Dominik-Workshop/KD-23MTS/documentation_PL.pdf

Projekt

Sterowniki robotów

# Dokumentacja

# Oscyloskop

# KD 23MTS

Skład grupy:
Dominik Pluta, 263460
Kamil Winnicki, 263434

Termin: srTN17

Prowadzący:
dr inż. Wojciech Domski

5 czerwca 2024

## Spis treści

1 Opis projektu | 2
2 Konfiguracja mikrokontrolera | 4
3 Urządzenia zewnętrzne | 8
4 Projekt elektroniki | 10
5 Opis działania programu | 11
6 Harmonogram pracy | 18
7 Podsumowanie | 19
8 Link do repozytorium projektu | 19
Bibilografia | 19

## 1 Opis projektu

Oscyloskop [2] [3] zbudowany w oparciu o mikrokontroler STM32L474RG oraz dotykowy, 4"wyświetlacz LCD. Stworzone urządzenie będzie posiadało następujące funkcjonalności:

- dwa kanały,
- skalowanie osi X oraz Y,
- przesuwanie wykresu w osi X oraz Y,
- dwa kursory w osi X oraz Y,
- pomiar RMS,
- pomiar peak-to-peak,
- pomiar częstotliwości,
- trigger,
- szybką transformate fouriera,

Do obsługi oscyloskopu przez użytkownika wykorzystany będzie enkoder oraz dotyk w ekranie.

Do testów oscyloskopu wykorzystany będzie sygnał PWM wygenerowany na jednym z pinów mikrokontrolera.

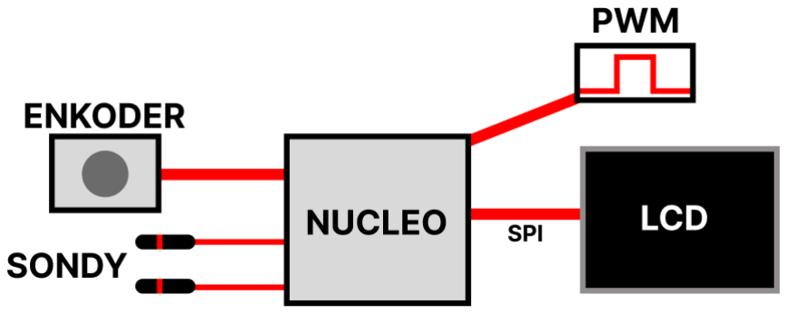
[picture p3: figure]

Rysunek 1: Architektura systemu

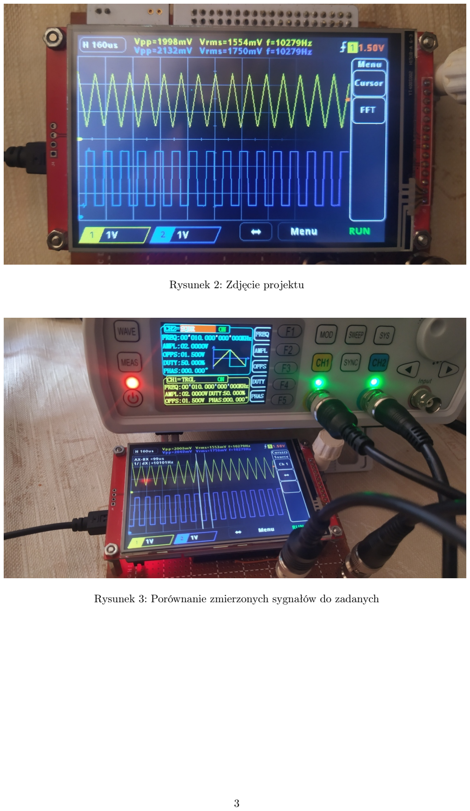
[picture p4: page 4]

Rysunek 2: Zdjęcie projektu

Rysunek 3: Porównanie zmierzonych sygnałów do zadanych

## 2 Konfiguracja mikrokontrolera

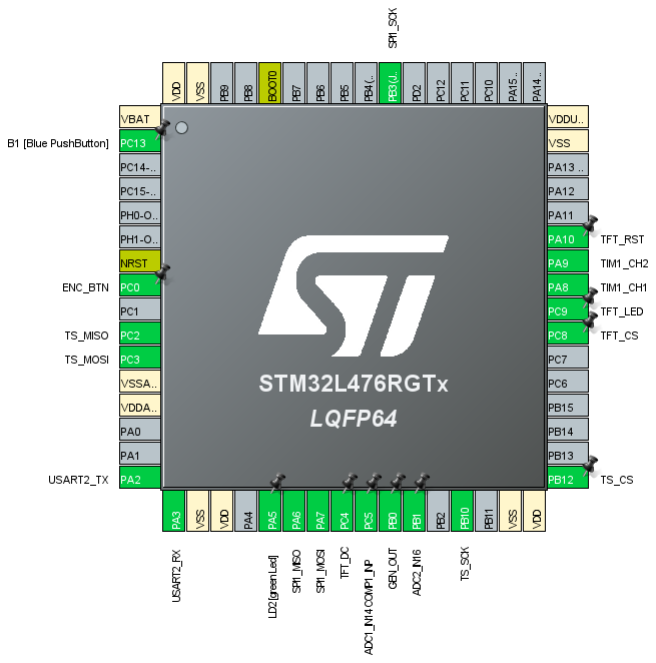
[picture p5: figure]

Rysunek 4: Konfiguracja wyjść mikrokontrolera w programie STM32CubeMX

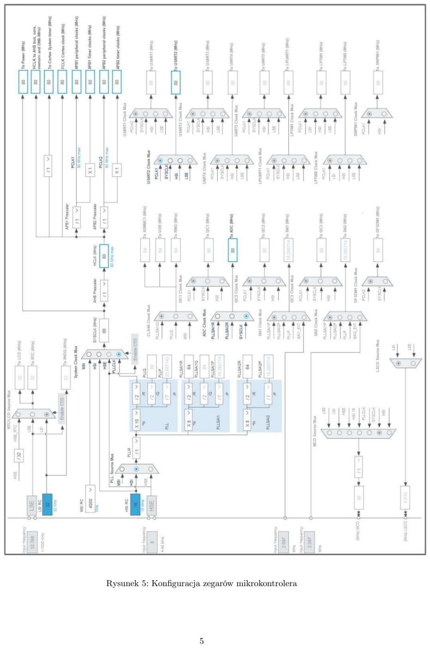
[picture p6: page 6]

Rysunek 5: Konfiguracja zegarów mikrokontrolera

### 2.1 Konfiguracja pinów

Numer pinu | PIN | Tryb pracy | Funkcja/etykieta
2 8 10 11 16 17 21 22 23 24 25 26 27 29 33 39 40 41 42 43 55 | PC13 PC0 PC2 PC3 PA2 PA3 PA5 PA6 PA7 PC4 PC5 PB0 PB1 PB10 PB12 PC8 PC9 PA8 PA9 PA10 PB3 | GPIO_EXTI13 GPIO_Input SPI_MISO SPI_MOSI USART2_TX USART2_RX GPIO_Output SPI_MISO SPI_MOSI GPIO_Output ADC1_IN2, COMP1_NP GPIO_Output ADC2_IN16 SPI2_SCK GPIO_Output GPIO_Output TIM3_CH4 TIM1_CH1 TIM1_CH2 GPIO_Output SPI1_SCK | B1 [Blue PushButton] ENC_BTN TS_MISO TS_MOSI USART2_TX USART2_RX LD2 [green Led] SPI1_MISO SPI1_MOSI TFT_DC CH1 & trigger GEN_OUT CH2 TS_SCK TS_CS TFT_CS TFT_LED TIM1_CH1 TIM1_CH2 TFT_RST SPI2_SCK

Tabela 1: Konfiguracja pinów mikrokontrolera

### 2.2 SPI1

Konfiguracja peryferium interfejsu SPI, wykorzystywanego do komunikacji z LCD. Wszystkie piny tego peryferium mają ustawione ’Maximum output’ speed na ’Very High’.

Parametr | Wartość
Mode | Full-Duplex Master
Frame Format | Motorola
Data Size | 8 bit
First bit | MSB first
Prescaler (for Baud Rate) | 2 (40 MBits/s)
Clock polarity | Low
Clock phase | 1 Edge

Tabela 2: Konfiguracja peryferium SPI

### 2.3 SPI2

Konfiguracja peryferium interfejsu SPI, wykorzystywanego do komunikacji z panelem dotykowym na LCD. Wszystkie piny tego peryferium mają ustawione ’Maximum output’ speed na ’Very High’.

Parametr | Wartość
Mode | Full-Duplex Master
Frame Format | Motorola
Data Size | 8 bit
First bit | MSB first
Prescaler (for Baud Rate) | 16 (5 MBits/s)
Clock polarity | Low
Clock phase | 1 Edge

Tabela 3: Konfiguracja peryferium SPI

### 2.4 ADC

Wykorzystujemy wbudowane przetworniki ADC w mikrokontrolerze. ADC1 odpowiada za pomiary z kanału 1 oscyloskopu, natomiast ADC2 za pomiary z kanału 2 oscyloskopu. Oba przetworniki zostały skonfigurowane w poniższy sposób.

Parametr | Wartość
Resolution | 12-bit
Continous conversion mode | Enabled
DMA Continuous Requests | Enabled
Sampling time | 6.5 Cycles

Tabela 4: Konfiguracja ADC

### 2.5 COMP1

Konfiguracja komparatora wykorzystywaego do implementacji triggera.

Parametr | Wartość
Input [-] | DAC OUT1
Speed/Power Mode | High Speed
Trigger Mode | Rising Edge Interrupt
Hysteresis Level | Low

Tabela 5: Konfiguracja komparatora

### 2.6 DAC1

Konfiguracja DAC używanego do implementacji triggera.

Parametr | Wartość
OUT1 mode | Connected to on chip-peripherals only
Output Buffer | Disable
Trigger | None

Tabela 6: Konfiguracja DAC

### 2.7 DMA

Używamy DMA do wysyłania danych do wyświetlacza, oraz zbierania próbek z ADC.

DMA request | Stream | Direction | Priority
SPI1_TX | DMA1_Channel3 | Memory To Peripheral | Low
ADC1 | DMA1_Channel1 | Peripheral To Memory | Low
ADC2 | DMA1_Channel2 | Peripheral To Memory | Low

Tabela 7: Konfiguracja DMA

### 2.8 TIM1

Timer 1 został wykorzystany do obsługi enkodera inkrementalnego.

Parametr | Wartość
Prescaler | 0
Counter Mode | Up
Counter Period | 65535
Internal Clock Division | No Division
Repetition Counter | 0
auto-reload preload | Disable
Encoder Mode | Encoder Mode TI1
Polarity | Rising Edge

Tabela 8: Konfiguracja TIM1

### 2.9 TIM4

Timer 4 został wykorzystany do wyzwalania pomiarów ADC gdy komparator ich nie wyzwala. Został skonfigurowany tak, żeby wyzwalał przerwanie co sekundę:

U pdate_event =

T IM_CLK
(P SC + 1)(ARR + 1)Hz | (1)

TIM_CLK = 80MHz, PSC = 7999, ARR = 9999

U pdate_event =

80MHz
(7999 + 1) ∗ (9999 + 1) = 1Hz | (2)
Parametr | Wartość
Prescaler | 7999
Counter Mode | Up
Counter Period | 9999
Internal Clock Division | No Division
auto-reload preload | Disable
Trigger Event Selection TRGO | Update Event

Tabela 9: Konfiguracja TIM4

### 2.10 USART2

Komunikacja przez USART jest wykorzystywana przy kalibracji dotyku wyświetlacza do wysłania m.in. nowych wartości kalibracyjnych.

Parametr | Wartość
Baud Rate | 115200 Bits/s
Word Length | 8 Bits (including parity)
Parity | None
Stop Bits | 1

Tabela 10: Konfiguracja USART

## 3 Urządzenia zewnętrzne

### 3.1 Wyświetlacz dotykowy LCD 480x320px

Wyświetlacz oparty jest o sterownik ILI9488 [1]. Dotyk w wyświetlaczu obsługiwany jest przez sterownik XPT2046.

### 3.2 Enkoder obrotowy KY-040

Enkoder będzie wykorzystywany do takich funkcji jak:

- skalowanie wykresu,
- przesuwanie wykresu,
- ustawianie triggera,
- ustawianie kursorów,

W celu obsługi tego peryferium TIMER 1 został skonfigurowany w trybie: "Combined Channels -Encoder Mode" [4]
Wyjścia DT oraz CLK zostały podpięte do wyjść timera 1 TIM1-CH1 oraz TIM1-CH2 co odpowiada pinom PA8 oraz PA9.
Odczyt impulsów z enkodera odbywa się poprzez odczyt wartości rejestru
htim1.Instance− > CNT | (3)

## 4 Projekt elektroniki

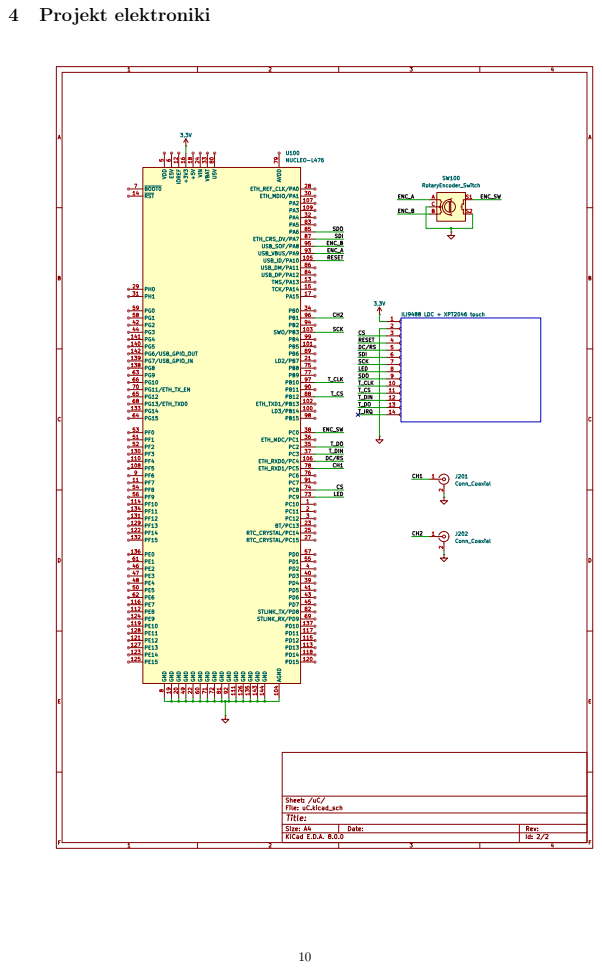
[picture p7: page 11]

## 5 Opis działania programu

### 5.1 Obsługa interfejsu

Obsługa większości funkcji oscyloskopu oparta jest o dotykowy wyświetlacz.
Dostępna funkcjonalność wyświetlacza:
- Po kliknięciu w wartość podzialki czasu na kratke, za pomocą enkodera można zmienić jej wartość,
- Po pierwszym kliknięciu w lewym dolnym rogu w odpowiedni kanał pojawia się menu gdzie po wyborze odpowiedniej opcji (skalowanie albo przesuwanie) można za pomocą enkodera wykonywać odpowiednie operacje.
- Kolejne kliknięcie w dany kanał powoduje wyświetlanie lub zaprzestanie wyświetlania wykresu.
- W sytuacji kliknięcia przycisku Menu, włącza się menu z dostępnymi opcjami: kursory oraz FFT.

### 5.2 Pomiary sygnałów z użyciem ADC

Jeden piksel na wyświetlaczu odpowiada jednej próbce z ADC, więc częstotliwość próbkowania została dobrana tak, aby przy 10 µs na działkę było zebranych 42 próbki (tyle pikseli ma jedna podziałka), więc powinna ona wynosić 4,2 MHz.
Częstotliwość próbkowania można wyliczyć ze wzoru (zakładając, że Clock Prescaler = ADC_CLOCK_ASYNC_DIV1):

fsampling =

ADC_clock
Sampling time + 12.5

Dobrałem wartości: ADC_clock = 80 MHz, Sampling time = 6.5

fsampling =

80 MHz
6.5 + 12.5

= 4.210526 MHz

Uzyskana częstotliwość odbiega od założonej, lecz rozbieżność ta jest pomijalnie mała. Jednakże lepszym rozwiązeniem prawdopodonie było by uniezależnienie częstotliwości próbkowania od ilości pikseli na działkę i skalowanie wyresu przez zmianę sposobu rysowania go.
Częstotliwość próbkowania ADC jest zmieniana w zależności od ustawionej podstawy czasu, dzięki czemu uzyskiwane jest skalowanie wykresu w dziedzinie czasu. Do wyboru jest 9 wartości podstawy czasu: 10, 20, 40, 80, 160, 320, 640, 1280 i 2560 µs. Zostało to zrealizowane w następujący sposób.
1 | swi t c h ( o s c i l l o s c o p e . timeBase_us ) {
2 | c a s e 1 0:
3 | hadc1 . I n i t . Cl o c kP r e s c al e r = ADC_CLOCK_ASYNC_DIV1;
4 | break ;
5 | c a s e 2 0:
6 | hadc1 . I n i t . Cl o c kP r e s c al e r = ADC_CLOCK_ASYNC_DIV2;
7 | break ;
8 | . . .
9 | . . .
10 | . . .
11 | c a s e 2 5 6 0:
12 | hadc1 . I n i t . Cl o c kP r e s c al e r = ADC_CLOCK_ASYNC_DIV256;
13 | break ;
14
15 | // I n i t i a l i z e the ADC with the c o n fi g u r e d s e t t i n g s
16 | i f (HAL_ADC_Init(&hadc1 ) != HAL_OK) {
17 | // I n i t i a l i z a t i o n E r r o r
18 | Error_Handler ( ) ;
19 | }
20 | }
| Warto zwrócić uwagę, żę powyższy kod zmienia prescaler dla zarówno dla ADC1, jak i dla ADC2.

### 5.3 Implementacja triggera

Przetwornik DAC1 ustawia napięcie zadziałania triggera następującą funkcją:

1 | HAL_DAC_SetValue(&hdac1 , DAC_CHANNEL_1, DAC_ALIGN_12B_R, conv_voltage_to_DAC (
| o s c i l l o s c o p e . triggerLevel_mV / 1 0 0 0. 0 ) ) ;
| Napięcie to jest odbierane na odwracającym wejściu komparatora COMP1 i jest porównywane z napięciem
| na wejściu nieodwracającym, które jest podłączone na tym samym pinie, co wejście kanału 1 oscyloskopu.
| Na zboczu narastającym sygnału na kanale 1 oscyloskopu, gdy wartość dorównuje napięciu ustawionemu
| przez DAC, wyzwalane jest przerwanie startujące zbieranie próbek na obu kanałach.
1 | v oid HAL_COMP_TriggerCallback (COMP_HandleTypeDef ∗hcomp ) {
2 | c omp a r a t o rT ri g ge redFl a g = 1 ;
3 | i f ( conv_done & done_drawing ) {
4 | conv_done = 0 ;
5 | HAL_ADC_Start_DMA(&hadc1 , ( uint32_t ∗) o s c i l l o s c o p e . ch1 . waveform_raw_adc ,
| MEMORY_DEPTH) ;
6 | HAL_ADC_Start_DMA(&hadc2 , ( uint32_t ∗) o s c i l l o s c o p e . ch2 . waveform_raw_adc ,
| MEMORY_DEPTH) ;
7 | ready_to_draw = 1 ;
8 | done_drawing = 0 ;
9 | }
10 | }
| Aby zapewnić działanie pomiaru sygnału nie wyzwalającego triggera, został użyty timer generujący
| przerwanie co sekundę, który startuje ADC, jeśli flaga mówiąca o wyzwoleniu komparatora nie jest usta-
| wiona, oraz gdy oscyloskop nie jest w trybie zatrzymania pomiaru.
1 | v oid HAL_TIM_PeriodElapsedCallback ( TIM_HandleTypeDef ∗htim ) {
2 | i f ( htim == &htim4 ) {
3 | i f ( ! c omp a r a t o rT ri g ge redFl a g && ! o s c i l l o s c o p e . s t o p ) {
4 | HAL_ADC_Start_DMA(&hadc1 , ( uint32_t ∗) o s c i l l o s c o p e . ch1 . waveform_raw_adc ,
| MEMORY_DEPTH) ;
5 | HAL_ADC_Start_DMA(&hadc2 , ( uint32_t ∗) o s c i l l o s c o p e . ch2 . waveform_raw_adc ,
| MEMORY_DEPTH) ;
6 | done_drawing = 0 ;
7 | }
8 | }
9 | }

### 5.4 Rysowanie wykresu

Poniższy kod rysuje wykres sygnału na ekranie. Warto zwrócić uwagę na użycie zmiennej offsetBetweenChannels, która służy zniwelowaniu przesunięcia fazowego między dwoma kanałami, powstałemu przez nie idealnie jednoczesne startowanie ADC.

1 | v oid draw_waveform ( O s cill o s c o p e_ c h a n n el ∗ ch , uint64_t timeBase_us , i n t o f f s e t , i n t
| s t o p ) {
2 | c o n s t ui n t o f f s e tB e tw e e nC h a n n el s = 3 6 0;
3 | f o r ( i n t i = 0 ; i < CANVA_WIDTH; ++i ) {
4 | i f ( ch−>number == 1 )
5 | ch−>wave form_display [ i ] = convertAdcToVoltage ( ch−>waveform_raw_adc [ i+o f f s e t
| +( o f f s e tB e tw e e nC h a n n el s / timeBase_us ) ] ) ∗1 0 0 0;
6 | e l s e
7 | ch−>wave form_display [ i ] = convertAdcToVoltage ( ch−>waveform_raw_adc [ i+o f f s e t
| ] ) ∗1 0 0 0;
8 | }
9 | f o r ( i n t i = 0 ; i < 420−1; ++i ) {
10 | i n t x0 = i ;
11 | i n t x1 = i +1;
12 | i n t y0 = CANVA_MIDDLE_V − ch−>y_ o f f s e t − ( ch−>wave form_display [ i ] ∗ 4 2 ) /ch−>
| y_scale_mV ;
13 | i n t y1 = CANVA_MIDDLE_V − ch−>y_ o f f s e t − ( ch−>wave form_display [ i +1]∗42) /ch−>
| y_scale_mV ;
14 | \\ Ensure t h a t the waveform f i n t s on the canva
15 | i f ( y0 < 3 2 )
16 | y0 = 3 2;
17 | i f ( y0 > 2 8 4 )
18 | y0 = 2 8 4;
19 | i f ( y1 < 3 2 )
20 | y1 = 3 2;
21 | i f ( y1 > 2 8 4 )
22 | y1 = 2 8 4;
23 | drawLine ( x0 , y0 , x1 , y1 , ch−>c o l o r ) ;
24 | }
25 | }

### 5.5 Pomiar peak-to-peak

1 | uint32_t calculate_peak_to_peak ( uint32_t ∗waveform ) {
2 | uint32_t max=0, min ;
3 | min = 5 0 0 0 0;
4 | f o r ( i n t i = 0 ; i < CANVA_WIDTH; ++i ) {
5 | i f ( waveform [ i ]<min ) {
6 | min=waveform [ i ] ;
7 | }
8 | i f ( waveform [ i ]>max) {
9 | max=waveform [ i ] ;
10 | }
11 | }
12 | r e t u r n max−min ;
13 | }

### 5.6 Pomiar RMS

1 | uint32_t calculate_RMS ( uint32_t ∗waveform ) {
2 | uint64_t sum_of_squares = 0 ;
3 | f o r ( i n t i = 0 ; i < CANVA_WIDTH; ++i ) {
4 | sum_of_squares += waveform [ i ] ∗ waveform [ i ] ;
5 | }
6 | f l o a t mean_of_squares = ( f l o a t ) sum_of_squares / CANVA_WIDTH;
7 | f l o a t rms = s q r t f ( mean_of_squares ) ;
8 | r e t u r n rms ;
9 | }

### 5.7 Obsługa wyświetlacza

Aby zapewnić akceptowalne działanie wyświetlacza zmodyfikowałem bibliotekę https://github.com/offpic/ILI9488-DMA-SPI-STM32-4-3.95-INCH-STM32F103-TOUCH, (https://github.com/offpic/ILI9488-DMA-SPI-STM32-4-3.95-INCH-STM32F103-TOUCH) aby używała bufora do rysowania na wyświetlaczu. Dzięki temu, obraz nie miga przy rysowaniu. Wadą takiego rozwiązania jest bardzo duże zużycie pamięci.

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

### 5.8 Kursory

W programie zawarte sa dwa rodzaje kursorów do wykonywania pomiarów:

- kursory poziome w osi Y - do pomiaru amplitudy,
- kursory pionowe w osi X - do pomiaru czasu,

Interfejs kursorów jako otwierane menu składa się z wyboru kanału, wyboru między kursorem w osi X i Y, oraz wyświetlenie wyniku pomiaru. Za pomocą kursorów pionowych dodatkowo można zmierzyć częstotliwość.
Kursory te działają w następujący sposób (Na przykładzie kursorów pionowych):
- Ustawienie danego kursora odbywa się na podstawie odczytu z enkodera gdzie ilość impulsów przekłada się bezpośrednio na pozycje, czyli gdy ilość impulsów równa się 200, kursor rysowany jest na pozycji 200-tego piksela w danej osi. Wartość ta dodawana jest do zmiennej globalnej, dla każdego z pojedynczych kursorów a następnie rejestr odpowiedzialny za ilość impulsów na enkoderze jest zerowany. Zmiana kursora odbywa się poprzez naciśniecie przycisku na enkoderze. Zaimplementowane jest również ograniczenie przesuwania kursorów aby nie wychodzily one poza kratki na wyswietlaczu.
- Obliczenie czasu lub amplitudy odbywa się za pomocą wzoru:
1 | time_1 = ( time_cursor_1 ∗ time_per_grid ) /PX_PER_GRID_X;
2 | time_2 = ( time_cursor_2 ∗ time_per_grid ) /PX_PER_GRID_X;
3
4 | time | = time_2 − time_1 ;

Gdzie:

– time 1 oraz time 2, zmienne w których przechowywany jest czas: "od zera do kursora"

– time-cursor-1 oraz time-cursor-2, są to zmienne przechowujące pozycje na którym pikselu znajduje się aktualnie kursor,

– time-per-grid, podziałka czas na kratke,

– PX-PER-GRID, ilośc pikseli na kratke na siatce wyswietlacza, wyznaczany ze wzoru: rozmiar wyświetlacza(w pikselach) / ilość kratek,

Przykład: kursor 1 = 105, kursor 2 = 210, czas na kratke = 100ms, piksele na kratke = 42,

time1 = ((105 ∗ 100)/42) = 250 | (4)
time2 = ((210 ∗ 100)/42) = 500 | (5)
time = 500 − 250 = 250ms | (6)

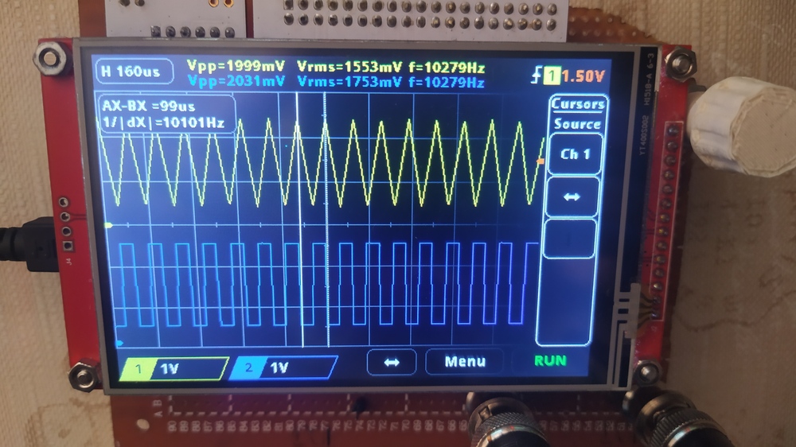
[picture p8: figure]

Rysunek 6: Kursory w osi X

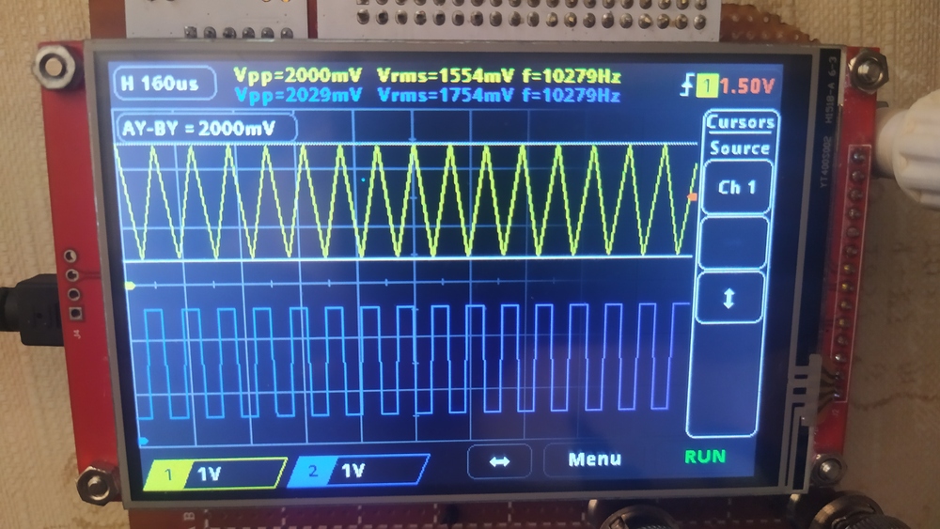
[picture p9: figure]

Rysunek 7: Kursory w osi Y

### 5.9 Szybka transformata Fouriera i pomiar częstotliwości

Pomiar częstotliwości zostal zaimplementowany przy użyciu transformaty FFT. Wyznaczana jest ona na podstawie widma. Szukana częstotliwosć sygnału jest tam gdzie słupek dla danej częstotliwości jest najwyższy (najwyższa amplituda).
Ze względu na pomiar częstotliwośći za pomocą FFT transformata FFT wykonywana jest z każdym przejściem pętli programu dla aktywnych kanałów.

Szybka Transformata Fouriera

- Użytkownik może włączyć FFT i wybrać kanał do analizy.
- Kod przetwarza dane sygnału z wybranego kanału za pomocą FFT, co pozwala na przekształcenie sygnału czasowego na widmo częstotliwościowe.
- Wyniki FFT są wyświetlane na ekranie oscyloskopu jako widmo częstotliwościowe, co pozwala użytkownikowi na analizę zawartości częstotliwościowej sygnału.

Wykonanie szybkiej transformaty Fouriera podzielone jest na dwie funkcje:
CalculateFFT():

1 v oid c alcul a teFFT ( O s cill o s c o p e_ c h a n n el ∗ ch , uint32_t s amplin g_ f requency ) {
2
3 | Complex X[ FFT_SIZE ] ;
4 | f o r ( i n t i = 0 ; i < FFT_SIZE; i++) {
5 | X[ i ] . r e a l = ch−>wave form_display [ i ] ;
6 | X[ i ] . imag = 0 ;
7 | }
8
9 f f t (X, FFT_SIZE) ;
10
11 | f o r ( i n t i = 0 ; i < FFT_SIZE / 2 ; i++) {
12 | ch−>f f t_ am pli t u d e [ i ] = s q r t (X[ i ] . r e a l ∗ X[ i ] . r e a l + X[ i ] . imag ∗ X[ i ] . imag ) ;
13 | ch−>f f t _ f r e q u e n c y [ i ] = ( i ∗ s amplin g_ f requency ) / FFT_SIZE;
14
15 }
16
17 | uint32_t amp_max = 0 ;
18 | uint32_t f r e q = 0 ;

19
20 | f o r ( i n t i = 1 ; i < FFT_SIZE / 2 ; i++){
21 | i f ( ch−>f f t_ am pli t u d e [ i ] > amp_max) {
22 | amp_max = ch−>f f t_ am pli t u d e [ i ] ;
23 | f r e q = ch−>f f t _ f r e q u e n c y [ i ] ;
24 | }
25 | }
26
27 | ch−>ch annel_ f requency = ( uint32_t ) f r e q ;
28 | }
| oraz fft():
1 | v oid f f t ( Complex ∗X, i n t N) {
2 | i f (N <= 1 ) r e t u r n ;
3
4 | Complex ∗X_even = ( Complex ∗) m all oc (N / 2 ∗ s i z e o f ( Complex ) ) ;
5 | Complex ∗X_odd = ( Complex ∗) m all oc (N / 2 ∗ s i z e o f ( Complex ) ) ;
6 | f o r ( i n t i = 0 ; i < N / 2 ; i++) {
7 | X_even [ i ] = X[ i ∗ 2 ] ;
8 | X_odd[ i ] = X[ i ∗ 2 + 1 ] ;
9 | }
10
11 | f f t (X_even , N / 2 ) ;
12 | f f t (X_odd, N / 2 ) ;
13
14 | f o r ( i n t k = 0 ; k < N / 2 ; k++) {
15 | d ouble t = −2 ∗ M_PI ∗ k / N;
16 | Complex e = { c o s ( t ) , s i n ( t ) } ;
17 | Complex temp = { e . r e a l ∗ X_odd[ k ] . r e a l − e . imag ∗ X_odd[ k ] . imag , e . r e a l ∗
| X_odd[ k ] . imag + e . imag ∗ X_odd[ k ] . r e a l } ;
18 | X[ k ] . r e a l = X_even [ k ] . r e a l + temp . r e a l ;
19 | X[ k ] . imag = X_even [ k ] . imag + temp . imag ;
20 | X[ k + N / 2 ] . r e a l = X_even [ k ] . r e a l − temp . r e a l ;
21 | X[ k + N / 2 ] . imag = X_even [ k ] . imag − temp . imag ;
22 | }
23 | f r e e (X_even ) ;
24 | f r e e (X_odd) ;
25 | }

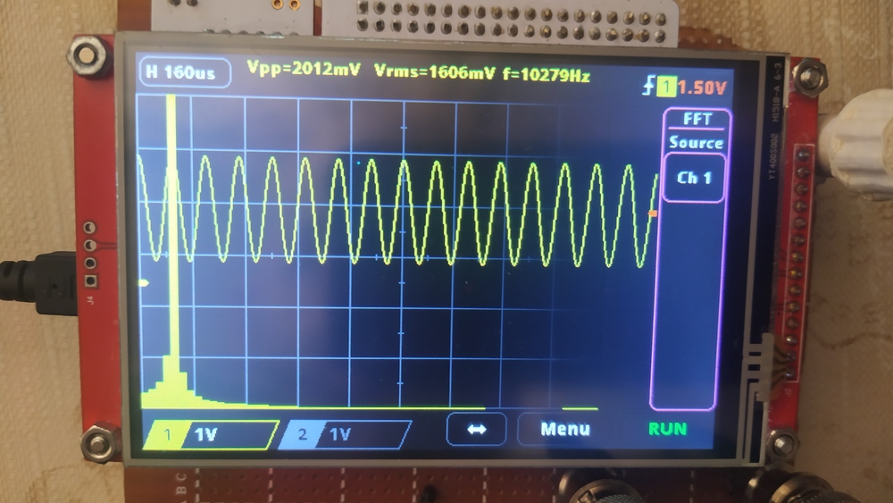
[picture p10: figure]

Rysunek 8: FFT dla sygnału sinusoidalnego

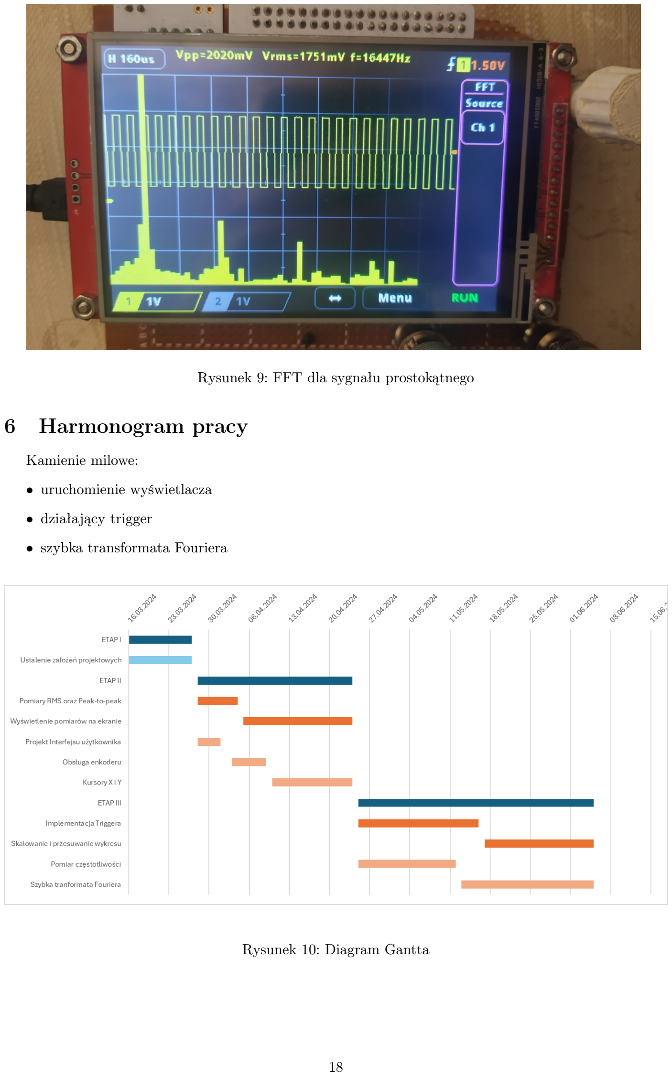
[picture p11: page 19]

Rysunek 9: FFT dla sygnału prostokątnego

## 6 Harmonogram pracy

Kamienie milowe:

- uruchomienie wyświetlacza
- działający trigger
- szybka transformata Fouriera

Rysunek 10: Diagram Gantta

### 6.1 Podział pracy

Dominik Pluta | % | Kamil Winnicki | %
Pomiar RMS i peak-to-peak | | Projekt interfejsu użytkownika
Obsługa wyświetlacza | | Obsługa Enkodera
Odczytywanie wartości z ADC | | Kursory w osi X
Wyświetlanie wykresu zmierzonego sygnału | | Kursory w osi Y

Tabela 11: Podział pracy – Etap II

Dominik Pluta | % | Kamil Winnicki | %
Implementacja triggera | | Pomiar częstotliwości
Rozciąganie i przesuwanie wykresu w osi X i Y | | Szybka transformata Fouriera

Tabela 12: Podział pracy – Etap III

## 7 Podsumowanie

Wszystkie założenia zostały zrealizowane i stworzony projekt spełnia funkcję prostego oscyloskopu o zakresie napięć wejściowych od 0V do 3.3V i częstotliwości do 400kHz a wykonywane pomiary są względnie dokładne. Należy jednak wspomnieć że po przekroczeniu około 100kHz działanie oscyloskopu znacznie zwalnia, ponieważ mikrokontroler jest w dużej części czasu zajęty przez obsługę przerwania od komparatora. Można by rozwiązać ten problem wyłączając komparator na pewien czas, lecz zabrakło nam czasu aby dopracować ten aspekt konstrukcji.
W przyszłości oscyloskop mógłby zostać ulepszony o dodatkowe układy elektronicznme które pozwoliły by na zwiększenie zakresu amplitudy mierzonych sygnałów.
Należy zwrócić uwagę, że aktualny kod do obsługi wyświetlacza zajmuje większość pamięci mikrokontrolera, co utrudnia rozbudowę projektu i uniemożwliwiło nam zwiększenie rozdzielczości wykonywanego FFT.

## 8 Link do repozytorium projektu

https://github.com/Dominik-Workshop/KD-23MTS

## Literatura

[1] hpinfotech. ILI9488 datasheet.
[2] J. Rydzewski. Oscyloskop elektroniczny. 1982.
[3] J. Rydzewski. Pomiary oscyloskopowe. 1999.
[4] ST. STM32L476R datasheet.
