Dominik-Workshop/KD-23MTS/images/photos/2ch_on.jpg

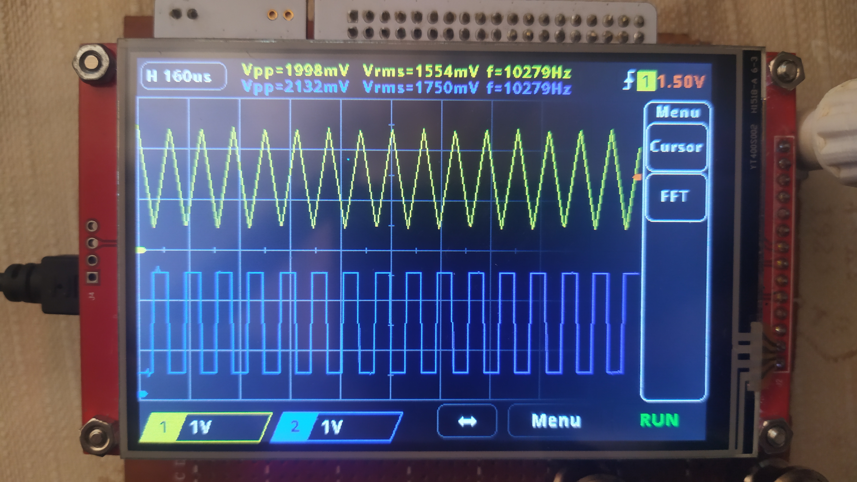
images/photos/2ch_on.jpg
