Dominik-Workshop/KD-23MTS/images/photos/sig_comparason.jpg

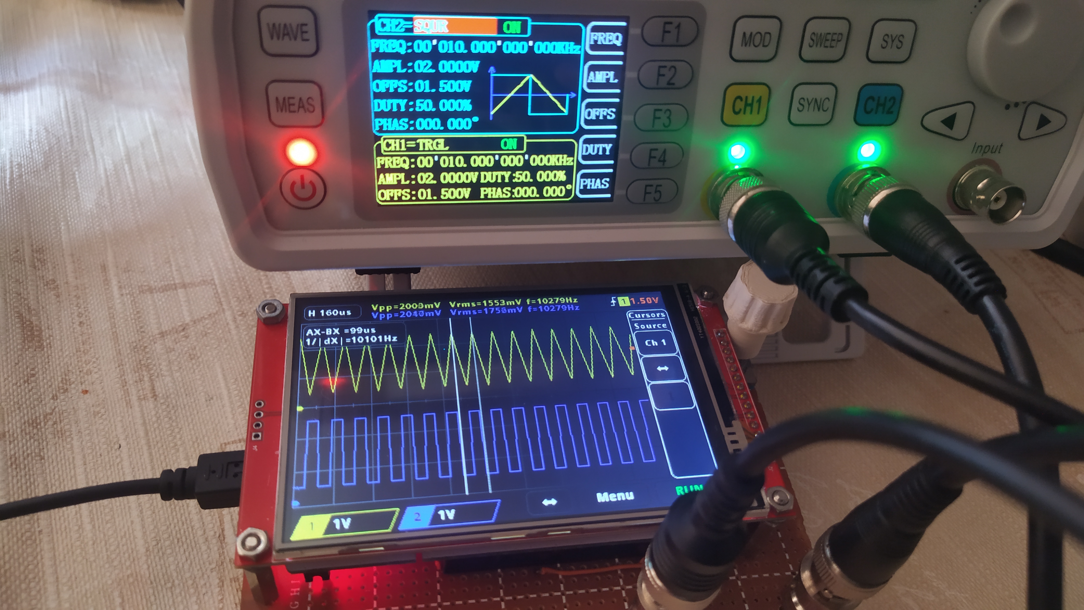
images/photos/sig_comparason.jpg
