Dominik-Workshop/KD-23MTS/code/Core/Inc/main.h

#define B1_Pin GPIO_PIN_13
#define B1_GPIO_Port GPIOC
#define ENC_BTN_Pin GPIO_PIN_0
#define ENC_BTN_GPIO_Port GPIOC
#define TS_MISO_Pin GPIO_PIN_2
#define TS_MISO_GPIO_Port GPIOC
#define TS_MOSI_Pin GPIO_PIN_3
#define TS_MOSI_GPIO_Port GPIOC
#define LD2_Pin GPIO_PIN_5
#define LD2_GPIO_Port GPIOA
#define TFT_DC_Pin GPIO_PIN_4
#define TFT_DC_GPIO_Port GPIOC
#define GEN_OUT_Pin GPIO_PIN_0
#define GEN_OUT_GPIO_Port GPIOB
#define TS_SCK_Pin GPIO_PIN_10
#define TS_SCK_GPIO_Port GPIOB
#define TS_CS_Pin GPIO_PIN_12
#define TS_CS_GPIO_Port GPIOB
#define TFT_CS_Pin GPIO_PIN_8
#define TFT_CS_GPIO_Port GPIOC
#define TFT_LED_Pin GPIO_PIN_9
#define TFT_LED_GPIO_Port GPIOC
#define TFT_RST_Pin GPIO_PIN_10
#define TFT_RST_GPIO_Port GPIOA
