Dominik-Workshop/KD-23MTS/code/Core/Inc/ts.h

/**
  ******************************************************************************
  * @file    ts.h
  * @author  MCD Application Team
  * @version V4.0.1
  * @date    21-July-2015
  * @brief   This file contains all the functions prototypes for the Touch Screen driver.
  ******************************************************************************
  * @attention
  *
  * <h2><center>&copy; COPYRIGHT(c) 2015 STMicroelectronics</center></h2>
  *
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
  ******************************************************************************
  */

/* Define to prevent recursive inclusion -------------------------------------*/
#ifndef __TS_H
#define __TS_H

#ifdef __cplusplus
 extern "C" {
#endif

/* Includes ------------------------------------------------------------------*/
#include <stdint.h> 

/** @addtogroup BSP
  * @{
  */

/** @addtogroup Components
  * @{
  */
    
/** @addtogroup TS
  * @{
  */

/** @defgroup TS_Exported_Types
  * @{
  */

/** @defgroup TS_Driver_structure  Touch Sensor Driver structure
  * @{
  */
typedef struct
{  
  void       (*Init)(uint16_t);
  uint16_t   (*ReadID)(uint16_t);
  void       (*Reset)(uint16_t);
  void       (*Start)(uint16_t);
  uint8_t    (*DetectTouch)(uint16_t);
  void       (*GetXY)(uint16_t, uint16_t*, uint16_t*);
  void       (*EnableIT)(uint16_t);
  void       (*ClearIT)(uint16_t);
  uint8_t    (*GetITStatus)(uint16_t);
  void       (*DisableIT)(uint16_t);
}TS_DrvTypeDef;
/**
  * @}
  */

/**
  * @}
  */

/**
  * @}
  */

/**
  * @}
  */

/**
  * @}
  */

#ifdef __cplusplus
}
#endif

#endif /* __TS_H */

/************************ (C) COPYRIGHT STMicroelectronics *****END OF FILE****/
