Dominik-Workshop/KD-23MTS/code/Core/Inc/sprites.h

/*
 * sprites.h
 *
 *  Created on: 3 maj 2024
 *      Author: Dominik
 */

#ifndef INC_SPRITES_H_
#define INC_SPRITES_H_

#include "inttypes.h"

const uint8_t trigRisingIcon[15][9];
const uint8_t arrowUpDown[15][8];
const uint8_t arrowLeftRight[7][15];

#endif /* INC_SPRITES_H_ */
