Dominik-Workshop/KD-23MTS/(commit log)

2024-03-17 adc dma not working idk why
    [main.c, main.h, oscilloscope.ioc]
2024-03-17 waveform caprures correctlygit add .!
    [main.c, oscilloscope.ioc]
2024-04-06 refactor, encoder moves waveform
2024-04-08 add ability to change different stuff with encoder
2024-04-09 add drawing rounded rectangle frame fnc
2024-05-04 touch works, calibration sequence
2024-05-04 describe calibration procedure
2024-05-31 minor fix, check if channel on
    [main.c]
2024-06-01 fix trigger changing with vertical scale
    [main.c, oscilloscope.c, oscilloscope.h]
2024-06-05 move button
